YuYang720/AVSD-2024-VPU-Project/4clock/log/FORMAL_PIC/AXI/{0822C34D-6553-48A7-A815-C82D6B12DF7F}.png.jpg

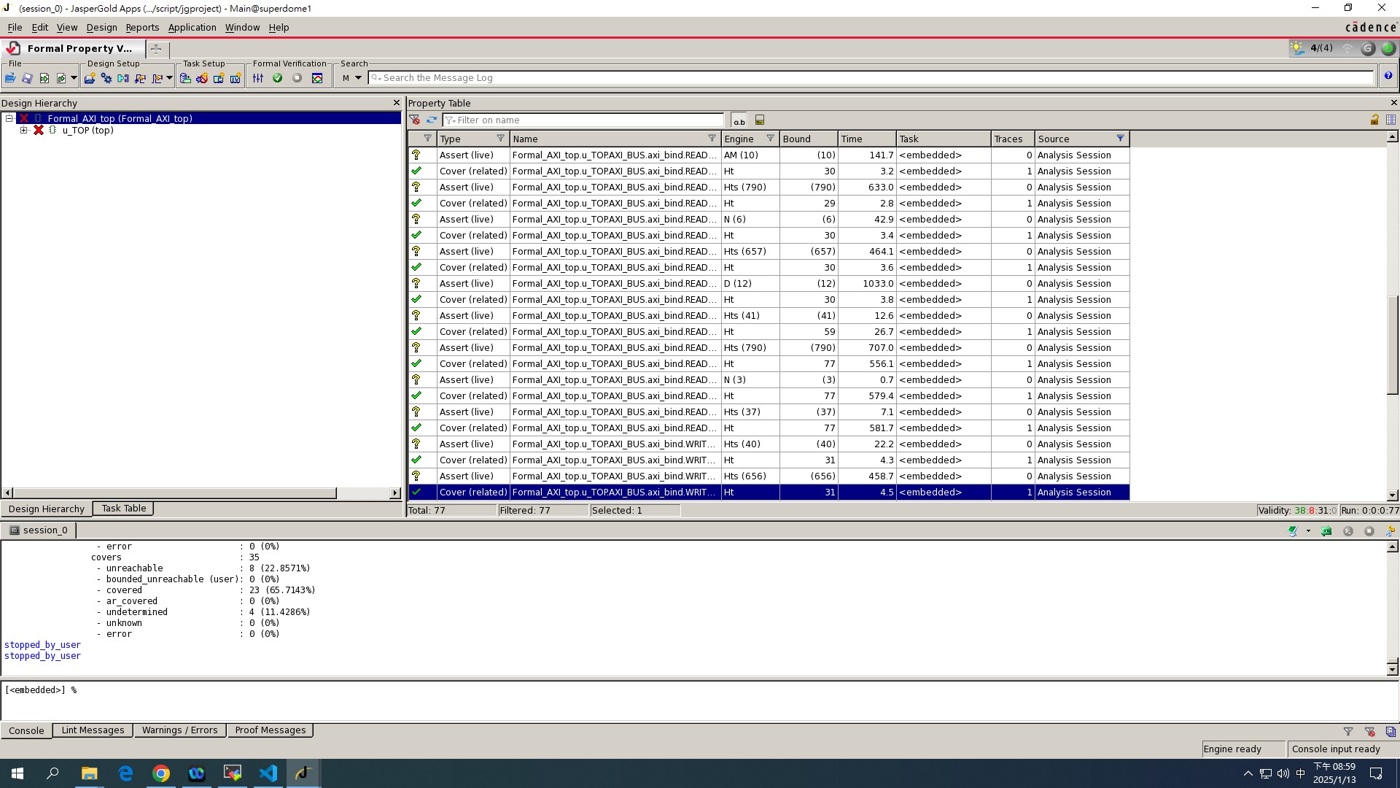
4clock/log/FORMAL_PIC/AXI/{0822C34D-6553-48A7-A815-C82D6B12DF7F}.png.jpg
