YuYang720/AVSD-2024-VPU-Project/4clock/log/FORMAL_PIC/AXI/{954101B8-FC87-4F8B-8295-84700027B3AD}.png.jpg

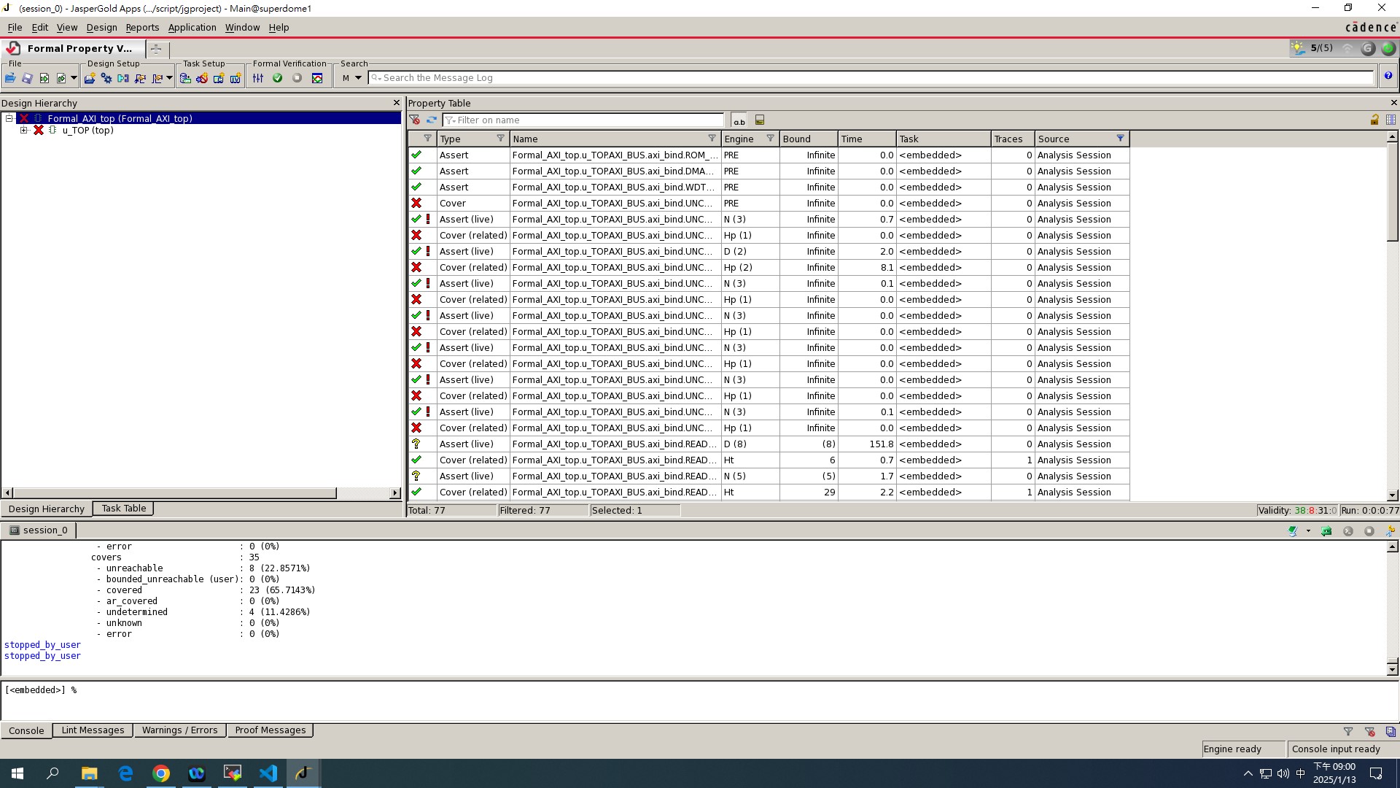
4clock/log/FORMAL_PIC/AXI/{954101B8-FC87-4F8B-8295-84700027B3AD}.png.jpg
