YuYang720/AVSD-2024-VPU-Project/4clock/log/FORMAL_PIC/ISA/CSR.jpg

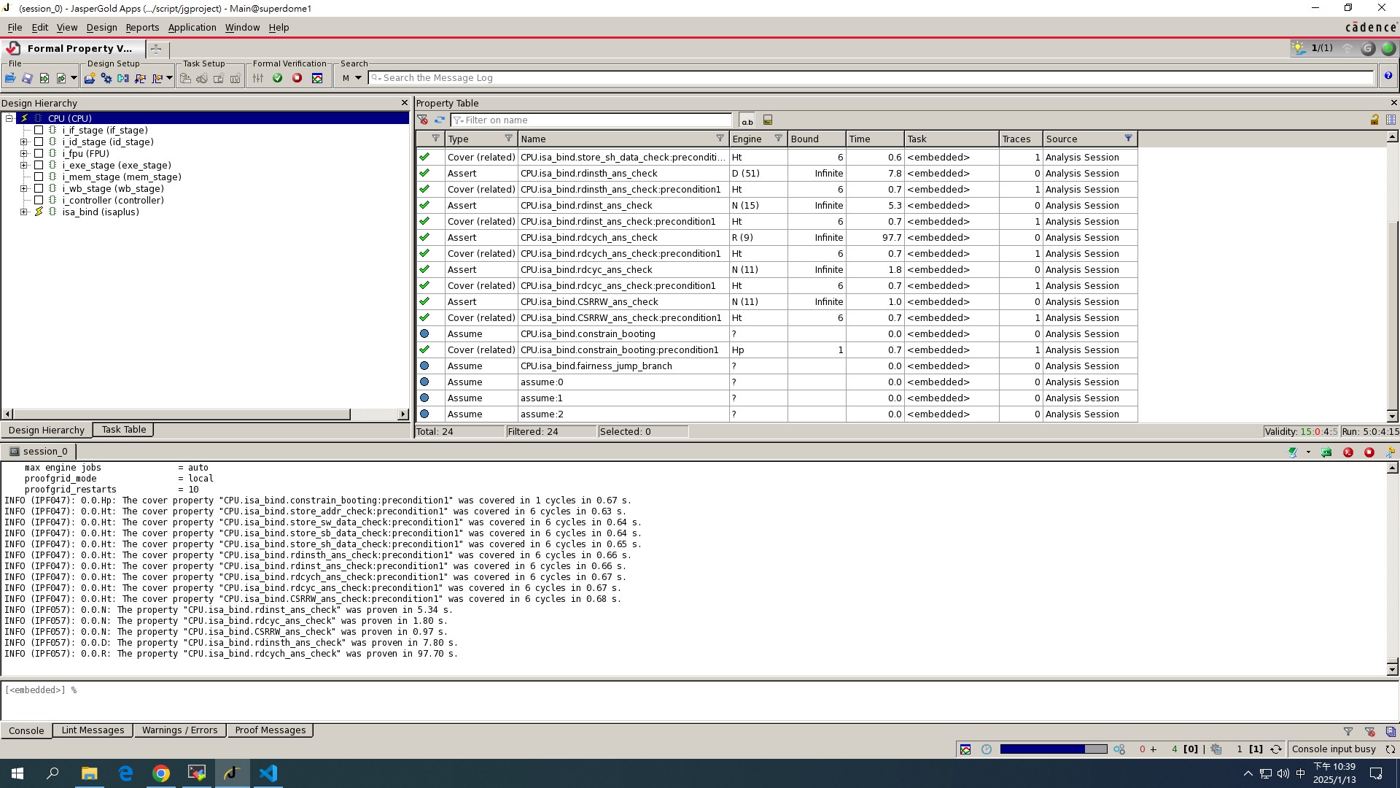
4clock/log/FORMAL_PIC/ISA/CSR.jpg
