YuYang720/AVSD-2024-VPU-Project/4clock/log/FORMAL_PIC/ISA/STORE.jpg

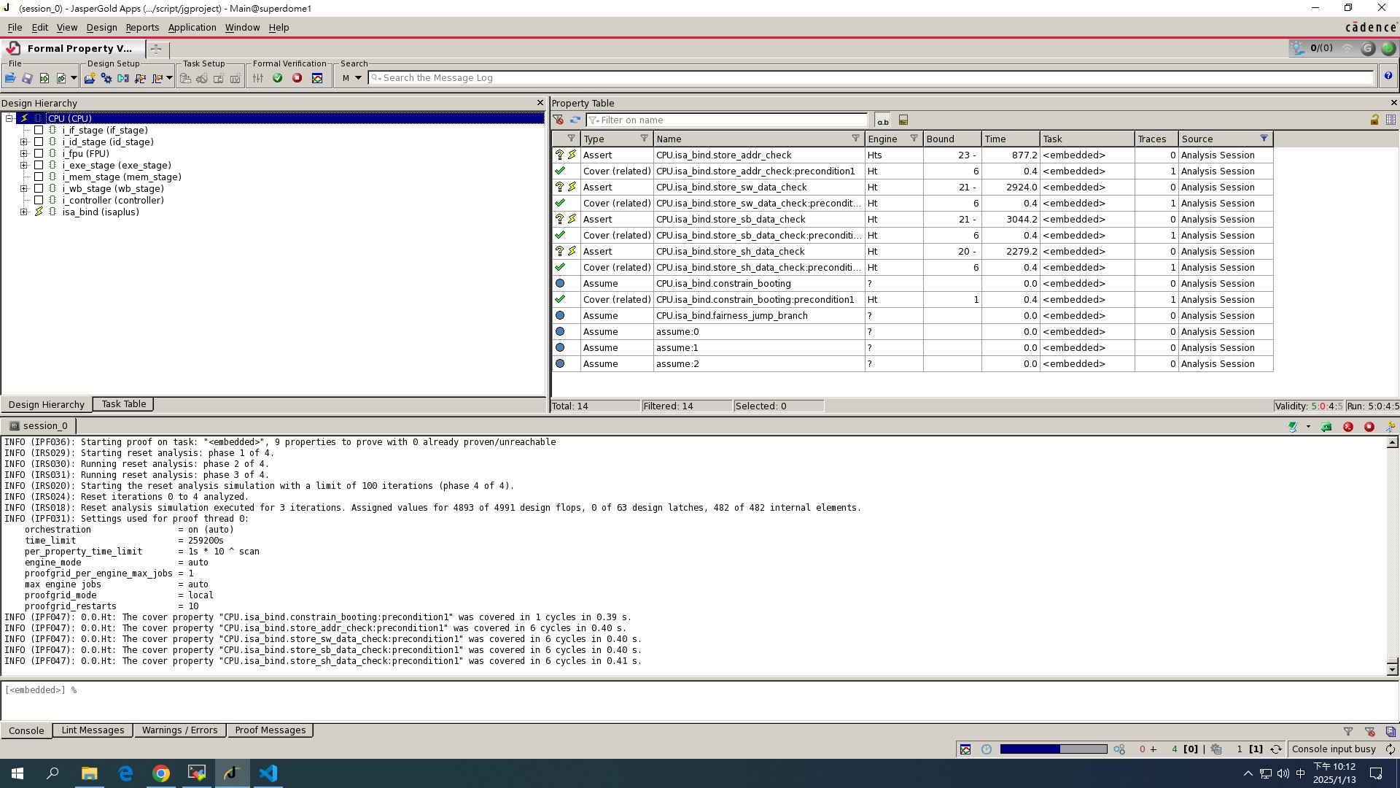
4clock/log/FORMAL_PIC/ISA/STORE.jpg
