YuYang720/AVSD-2024-VPU-Project/4clock/log/FORMAL_PIC/ISA/螢幕擷取畫面 2025-01-13 040731.png

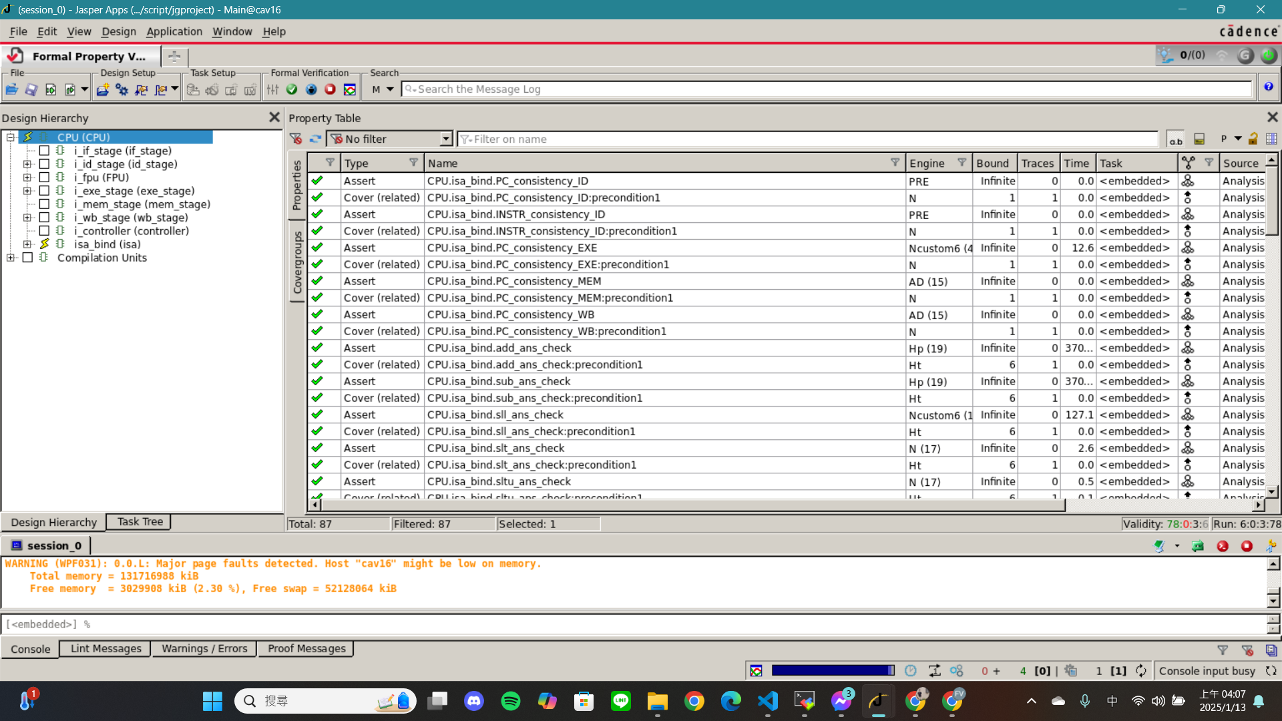
4clock/log/FORMAL_PIC/ISA/螢幕擷取畫面 2025-01-13 040731.png
