YuYang720/AVSD-2024-VPU-Project/4clock/log/Screenshot 2025-01-14 084918.png

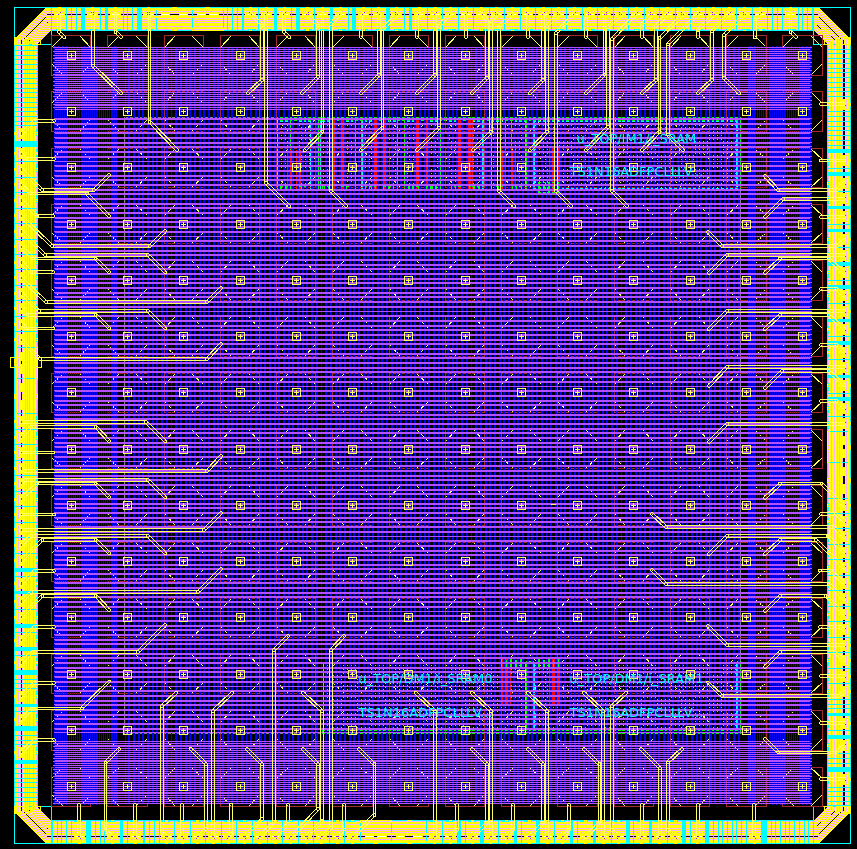
4clock/log/Screenshot 2025-01-14 084918.png
